8wallace8/AVMeter/README.md

"# AVMeter"

Versiion 1.2 fixes input order for LM6105.  Also adds negative voltage supply directly from PSU's board.
