8wallace8/AVMeter/Kicad/BOM.xlsx

Type | value5 | quantity | datasheet | mouser/digikey | last order | In Stock | Need
Cap | 0.1uf | 11 | https://www.mouser.com/datasheet/2/212/KEM_C1002_X7R_SMD-1102033.pdf | https://www.mouser.com/ProductDetail/80-C1206C104K5R7210 | 50 | 25 | 14
Cap | 10uf | 2 | https://www.mouser.com/datasheet/2/400/lcc_commercial_general_en-837201.pdf | https://www.mouser.com/ProductDetail/810-C3216JB1C106K16A | 20 | 17 | 15
Cap | 220nf | 3 | https://www.mouser.com/datasheet/2/427/vjw1bcbascomseries-223529.pdf | https://www.mouser.com/ProductDetail/77-VJ1206Y224MXATBC | 20 | 14 | 11
Cap | 820uf | 4 | https://www.mouser.com/datasheet/2/315/ABA0000C1255-1128316.pdf | https://www.mouser.com/ProductDetail/667-EEU-FS1A821 | 0 |  | -4
D1 | LM4040DBZ-2.0 | 1 | http://www.ti.com/general/docs/suppproductinfo.tsp?distId=26 | https://www.mouser.com/ProductDetail/926-LM4040AIM3X20NPB | 3 | 2 | 1
D2 | 1N4448WQ | 1 | https://www.mouser.com/datasheet/2/115/ds12002-536532.pdf | https://www.mouser.com/ProductDetail/621-1N4448WQ-7-F | 10 | 7 | 6
Resistor | 1.5K | 3 | https://www.mouser.com/datasheet/2/54/hpreztr-777398.pdf | https://www.mouser.com/ProductDetail/652-CR1206FX-1501ELF | 100 | 50 | 47
Resistor | 10K | 1 | https://www.mouser.com/datasheet/2/427/crcwce3-1223726.pdf | https://www.mouser.com/ProductDetail/71-CRCW120610K0FKEAC | 20 | 26 | 25
Resistor | 150 | 6 | https://www.mouser.com/datasheet/2/315/AOA0000C307-1149632.pdf | https://www.mouser.com/ProductDetail/667-ERA-8AEB151V | 10 | 8 | 2
Resistor | 18K | 4 | https://www.mouser.com/datasheet/2/315/AOA0000C307-1149632.pdf | https://www.mouser.com/ProductDetail/667-ERA-8AEB183V | 10 | 8 | 4
Resistor | 1K | 3 | https://www.mouser.com/datasheet/2/315/AOA0000C307-1149632.pdf | https://www.mouser.com/ProductDetail/667-ERA-8AEB102V | 6 | 9 | 6
Resistor | 330 | 3 | https://www.mouser.com/datasheet/2/447/PYu-AC_51_RoHS_L_6-1152827.pdf | https://www.mouser.com/ProductDetail/603-AC1206JR-07330RL | 30 | 24 | 21
Resistor | 3K | 1 | https://www.mouser.com/datasheet/2/315/AOA0000C304-1149620.pdf | https://www.mouser.com/ProductDetail/667-ERJ-8ENF3001V | 20 | 19 | 18
Resistor | 50m | 3 | https://www.mouser.com/datasheet/2/315/AOA0000C325-1316773.pdf | https://www.mouser.com/ProductDetail/667-ERJ-B2CFR05V | 3 | 3 | 0
U1 | LT6105 | 3 | https://www.mouser.com/datasheet/2/609/6105fa-1269918.pdf | https://www.mouser.com/ProductDetail/584-LT6105IMS8%23PBF | 3 |  | -3
U4 | LM321 | 1 | http://www.ti.com/general/docs/suppproductinfo.tsp?distId=26 | https://www.mouser.com/ProductDetail/926-LM321MFX-NOPB | 3 | 1 | 0
U5 | MCP3208 | 1 | https://www.mouser.com/datasheet/2/268/21298e-1101808.pdf | https://www.mouser.com/ProductDetail/579-MCP3208T-CI-SL | 3 | 1 | 0
U6 | ATmega328-PU | 1 | https://www.mouser.com/datasheet/2/268/Atmel-8271-8-bit-AVR-Microcontroller-ATmega48A-48P-1315288.pdf | https://www.mouser.com/ProductDetail/556-ATMEGA328-PU | 3 | 2 | 1
U7 | L7805 | 1 | https://www.mouser.com/datasheet/2/389/l78-974043.pdf | https://www.mouser.com/ProductDetail/511-L7805CDT-TR | 3 | 1 | 0
