8wallace8/AVMeter/Kicad/AVMeter.kicad_pcb

## KiCad design Kicad/AVMeter.kicad_pcb (2019-08-14)

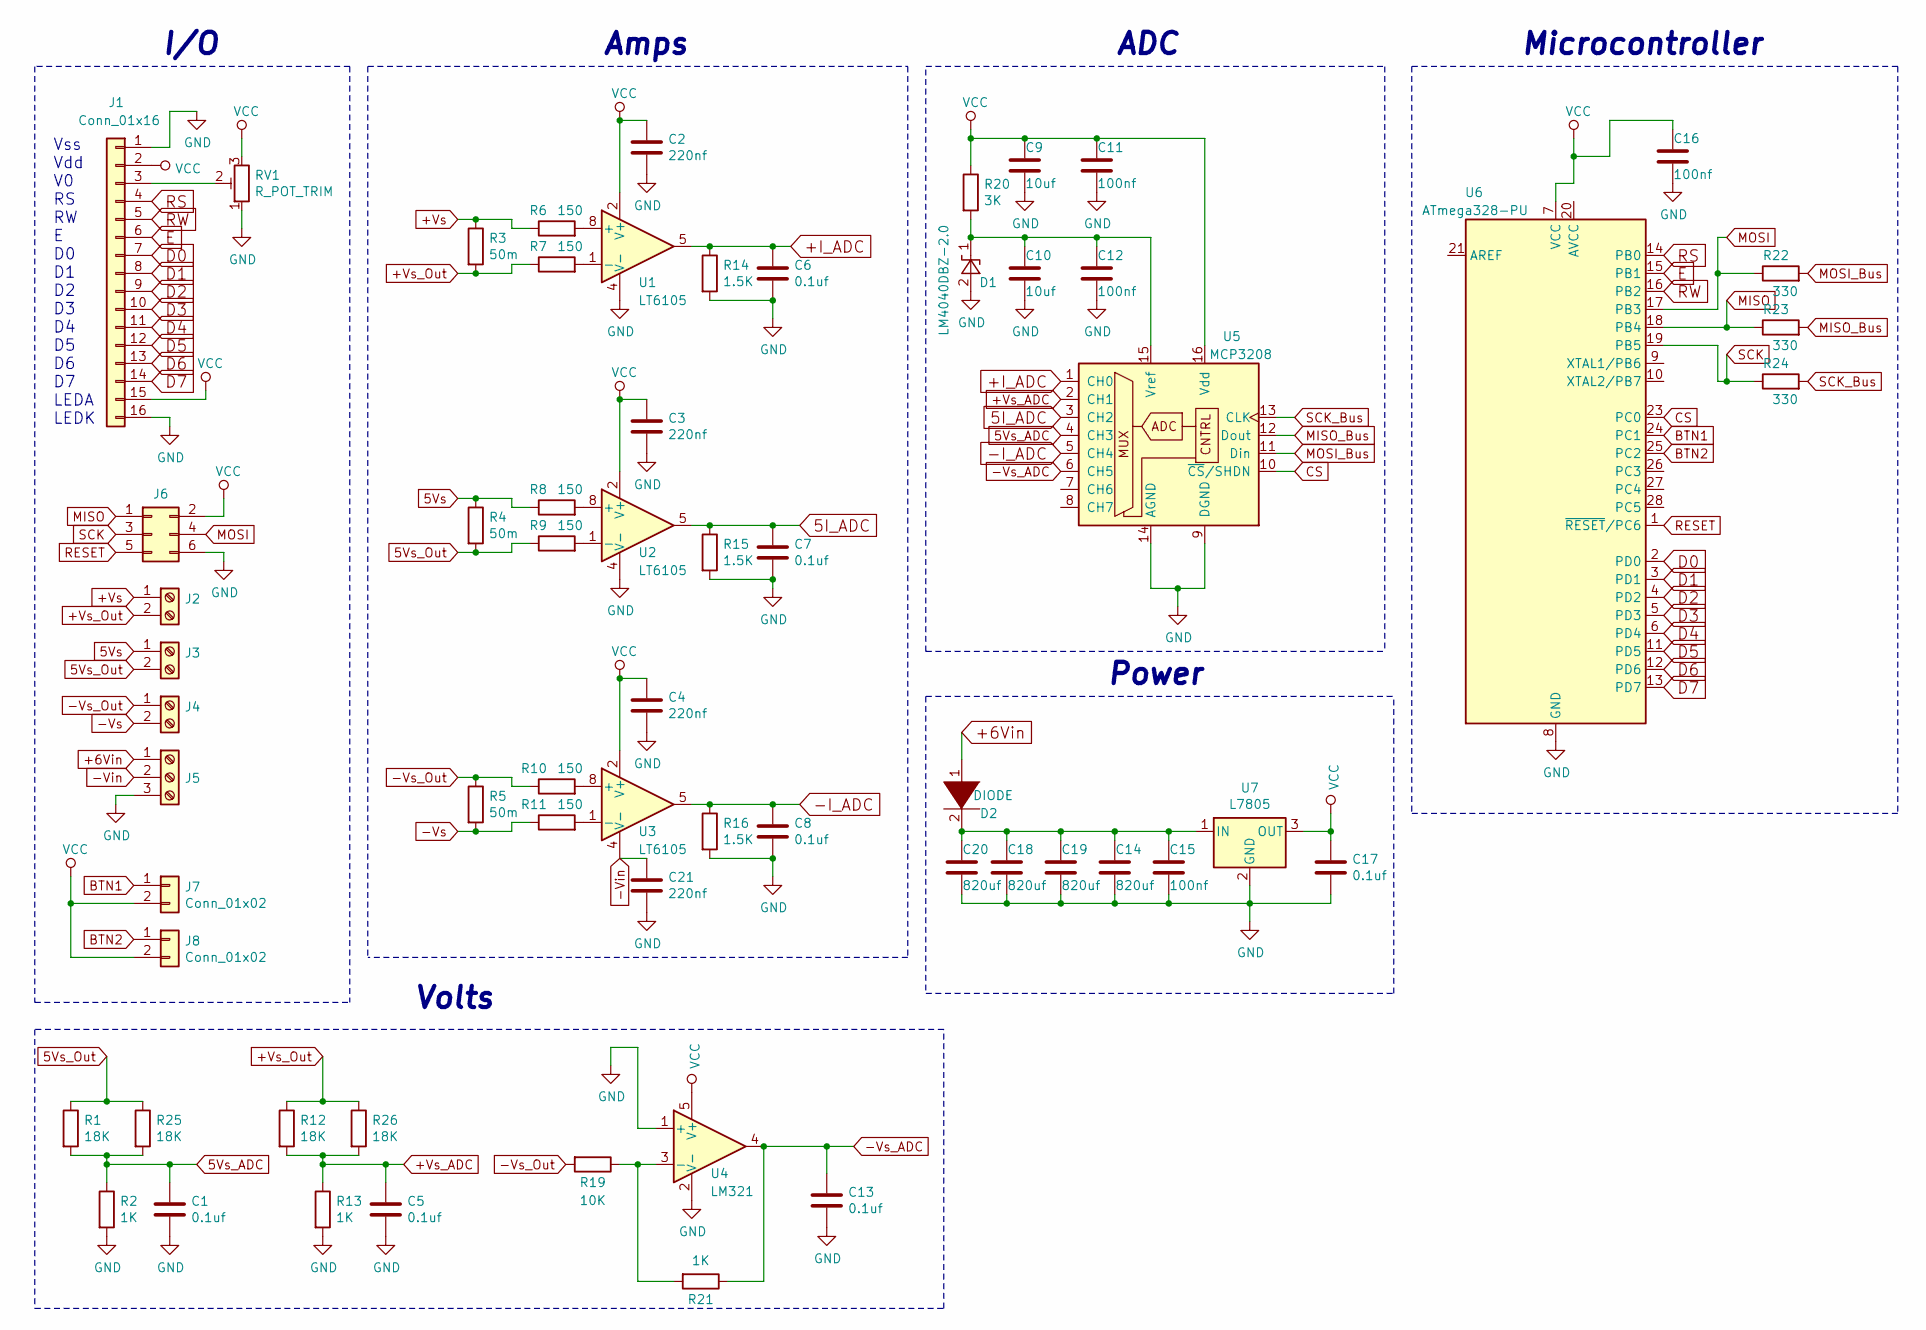
[picture p1: schematic AVMeter.sch]

Parts:
C1, C5, C6, C7, C8, C13, C17: 0.1uf; C_1206_3216Metric_Pad1.42x1.75mm_HandSolder
C2, C3, C4, C21: 220nf; C_1206_3216Metric_Pad1.42x1.75mm_HandSolder
C9, C10: 10uf; C_1206_3216Metric_Pad1.42x1.75mm_HandSolder
C11, C12, C15, C16: 100nf; C_1206_3216Metric_Pad1.42x1.75mm_HandSolder
C14, C18, C19, C20: 820uf; CP_Radial_D8.0mm_P3.50mm
D1: LM4040DBZ-2.0; SOT-23
D2: DIODE; D_SOD-123F
J1: Conn_01x16; PinHeader_1x16_P2.54mm_Vertical
J2, J3, J4: Screw_Terminal_01x02; KF301_2Pin_5Pitch
J5: Screw_Terminal_01x03; KF301_3Pin_5Pitch
J6: Conn_02x03_Odd_Even; PinHeader_2x03_P2.54mm_Vertical
J7, J8: Conn_01x02; PinSocket_1x02_P2.54mm_Vertical
R1, R12, R25, R26: 18K; R_1206_3216Metric_Pad1.42x1.75mm_HandSolder
R2, R13, R21: 1K; R_1206_3216Metric_Pad1.42x1.75mm_HandSolder
R3, R4, R5: 50m; R_0612_1632Metric_Pad1.18x3.40mm_HandSolder
R6, R7, R8, R9, R10, R11: 150; R_1206_3216Metric_Pad1.42x1.75mm_HandSolder
R14, R15, R16: 1.5K; R_1206_3216Metric_Pad1.42x1.75mm_HandSolder
R19: 10K; R_1206_3216Metric_Pad1.42x1.75mm_HandSolder
R20: 3K; R_1206_3216Metric_Pad1.42x1.75mm_HandSolder
R22, R23, R24: 330; R_1206_3216Metric_Pad1.42x1.75mm_HandSolder
RV1: R_POT_TRIM; PinHeader_1x03_P2.54mm_Vertical
U1, U2, U3: LT6105; MSOP-8_3x3mm_P0.65mm
U4: LM321; SOT-23-5
U5: MCP3208; SOIC-16_3.9x9.9mm_P1.27mm
U6: ATmega328-PU; DIP-28_W7.62mm
U7: L7805; L7805CDT-TR-DPAK

Connections:
5I_ADC: C7.1, R15.1, U2.5, U5.3 (CH2)
5Vs: J3.1, R4.1, R8.1
5Vs_ADC: C1.1, R1.2, R2.1, R25.2, U5.4 (CH3)
5Vs_Out: J3.2, R1.1, R4.2, R9.1, R25.1
+6Vin: D2.1 (K), J5.1
+I_ADC: C6.1, R14.1, U1.5, U5.1 (CH0)
+Vs: J2.1, R3.1, R6.1
+Vs_ADC: C5.1, R12.2, R13.1, R26.2, U5.2 (CH1)
+Vs_Out: J2.2, R3.2, R7.1, R12.1, R26.1
-I_ADC: C8.1, R16.1, U3.5, U5.5 (CH4)
-Vin: C21.1, J5.2, U3.4 (V-)
-Vs: J4.2, R5.2, R11.1
-Vs_ADC: C13.1, R21.1, U4.4, U5.6 (CH5)
-Vs_Out: J4.1, R5.1, R10.1, R19.2
BTN1: J7.1, U6.24 (PC1)
BTN2: J8.1, U6.25 (PC2)
CS: U5.10 (~CS~/SHDN), U6.23 (PC0)
D0: J1.7, U6.2 (PD0)
D1: J1.8, U6.3 (PD1)
D2: J1.9, U6.4 (PD2)
D3: J1.10, U6.5 (PD3)
D4: J1.11, U6.6 (PD4)
D5: J1.12, U6.11 (PD5)
D6: J1.13, U6.12 (PD6)
D7: J1.14, U6.13 (PD7)
E: J1.6, U6.15 (PB1)
GND: C1.2, C2.2, C3.2, C4.2, C5.2, C6.2, C7.2, C8.2, C9.2, C10.2, C11.2, C12.2, C13.2, C14.2, C15.2, C16.2, C17.2, C18.2, C19.2, C20.2, C21.2, D1.2 (A), J1.1, J1.16, J5.3, J6.6, R2.2, R13.2, R14.2, R15.2, R16.2, RV1.1, U1.4 (V-), U2.4 (V-), U4.1 (+), U4.2 (V-), U5.9 (DGND), U5.14 (AGND), U6.8 (GND), U6.22 (GND), U7.2 (GND)
MISO: J6.1, R23.1, U6.18 (PB4)
MISO_Bus: R23.2, U5.12 (Dout)
MOSI: J6.4, R22.1, U6.17 (PB3)
MOSI_Bus: R22.2, U5.11 (Din)
unnamed: C10.1, C12.1, D1.1 (K), R20.2, U5.15 (Vref)
unnamed: C14.1, C15.1, C18.1, C19.1, C20.1, D2.2 (A), U7.1 (IN)
unnamed: J1.3, RV1.2
unnamed: R6.2, U1.8 (+)
unnamed: R7.2, U1.1 (-)
unnamed: R8.2, U2.8 (+)
unnamed: R9.2, U2.1 (-)
unnamed: R10.2, U3.8 (+)
unnamed: R11.2, U3.1 (-)
unnamed: R19.1, R21.2, U4.3 (-)
RESET: J6.5, U6.1 (~RESET~/PC6)
RS: J1.4, U6.14 (PB0)
RW: J1.5, U6.16 (PB2)
SCK: J6.3, R24.1, U6.19 (PB5)
SCK_Bus: R24.2, U5.13 (CLK)
VCC: C2.1, C3.1, C4.1, C9.1, C11.1, C16.1, C17.1, J1.2, J1.15, J6.2, J7.2, J8.2, R20.1, RV1.3, U1.2 (V+), U2.2 (V+), U3.2 (V+), U4.5 (V+), U5.16 (Vdd), U6.7 (VCC), U7.3 (OUT)

Notes on the sheet:
Vss Vdd V0 RS RW E D0 D1 D2 D3 D4 D5 D6 D7 LEDA LEDK
I/O
Amps
ADC
Microcontroller
Power
Volts

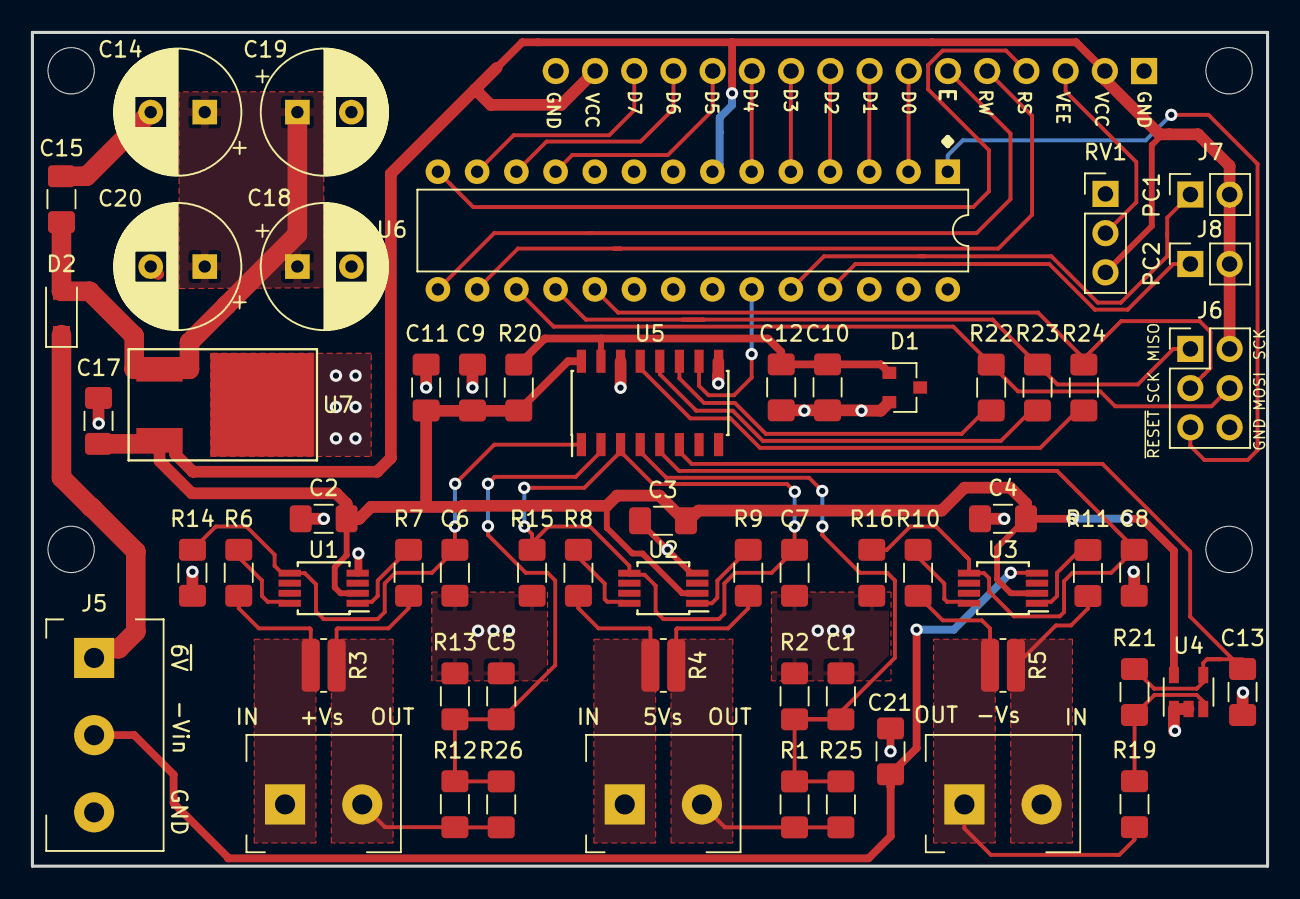
[picture p2: board AVMeter.kicad_pcb from above]

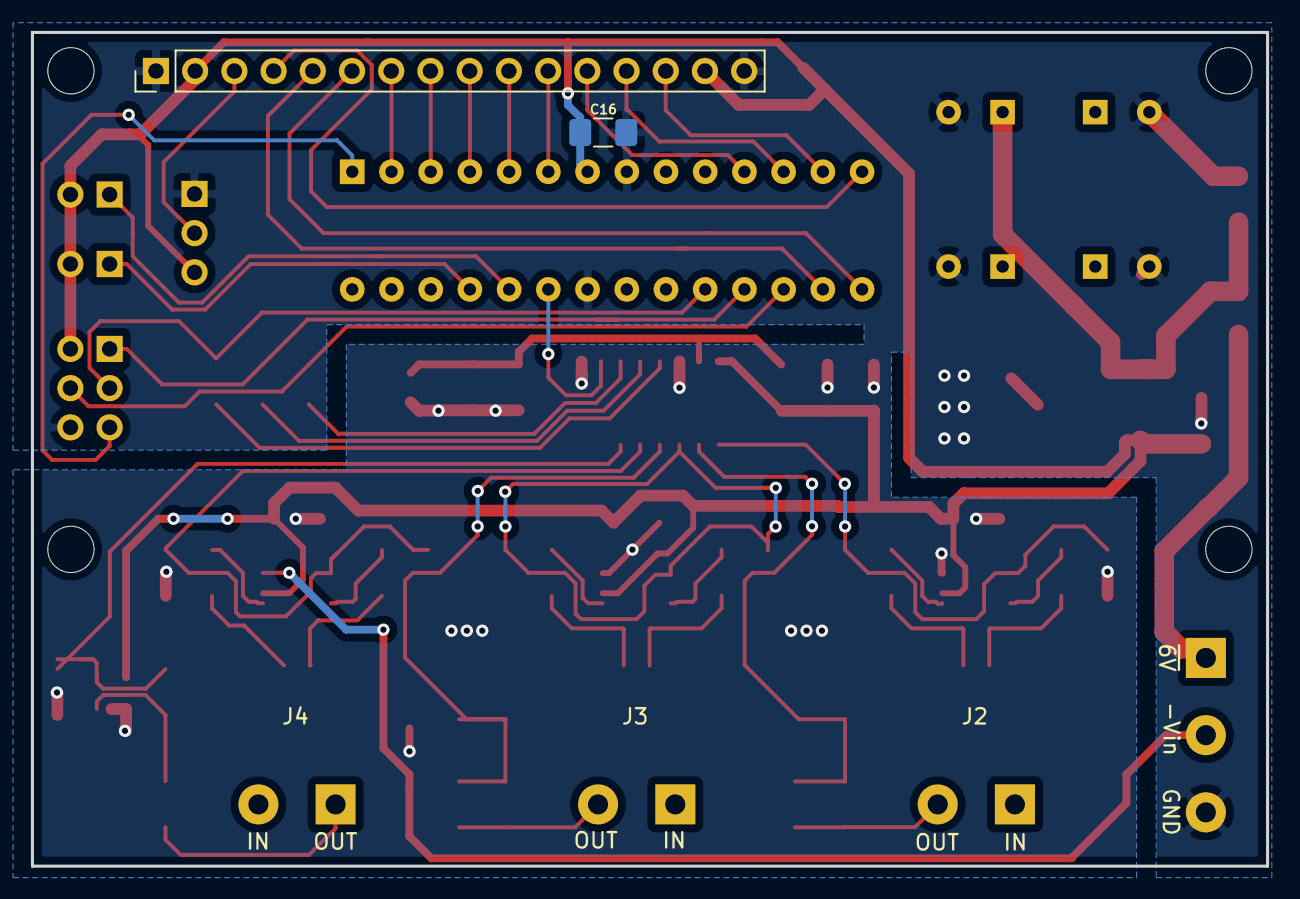
[picture p3: board AVMeter.kicad_pcb from below]

Board: 2 copper layers, 80.0 x 54.0 mm, 63 parts (2 on the bottom side), 47 nets.
