8wallace8/AVMeter/Code/AVMeter/lcd_4bit.h

/*
 * lcd.h
 *
 * Created: 2/3/2019 3:05:04 PM
 *  Author: dkyle
 */ 

#ifndef ldc
#define ldc

#include <avr/io.h>			/* Include AVR std. library file */
#include <util/delay.h>			/* Include Delay header file */

#define LCD_Dir  DDRD			/* Define LCD data port direction */
#define LCD_Port PORTD			/* Define LCD data port */
#define CONTROL_Dir DDRB
#define CONTROL_Port PORTB
#define RS PINB0				/* Define Register Select pin */
#define EN PINB1 				/* Define Enable signal pin */
#define RW PINB2

void LCD_Command( unsigned char cmnd );
void LCD_Char( unsigned char data );
void LCD_Init (void);			/* LCD Initialize function */
void LCD_String (char *str);		/* Send string to LCD function */
void LCD_String_xy (char row, char pos, char *str);	/* Send string to LCD with xy position */
void LCD_Clear(void);
void LCD_Custom_Char (unsigned char loc, unsigned char *msg);



void LCD_Command( unsigned char cmnd )
{
	LCD_Port = (LCD_Port & 0x0F) | (cmnd & 0xF0); /* sending upper nibble */
	CONTROL_Port &= ~ (1<<RS);		/* RS=0, command reg. */
	CONTROL_Port |= (1<<EN);		/* Enable pulse */
	_delay_us(1);
	CONTROL_Port &= ~ (1<<EN);

	_delay_us(200);

	LCD_Port = (LCD_Port & 0x0F) | (cmnd << 4);  /* sending lower nibble */
	CONTROL_Port |= (1<<EN);
	_delay_us(1);
	CONTROL_Port &= ~ (1<<EN);
	_delay_ms(2);
}


void LCD_Char( unsigned char data )
{
	LCD_Port = (LCD_Port & 0x0F) | (data & 0xF0); /* sending upper nibble */
	CONTROL_Port |= (1<<RS);		/* RS=1, data reg. */
	CONTROL_Port|= (1<<EN);
	_delay_us(1);
	CONTROL_Port &= ~ (1<<EN);

	_delay_us(200);

	LCD_Port = (LCD_Port & 0x0F) | (data << 4); /* sending lower nibble */
	CONTROL_Port |= (1<<EN);
	_delay_us(1);
	CONTROL_Port &= ~ (1<<EN);
	_delay_ms(2);
}

void LCD_Init (void)			/* LCD Initialize function */
{
	LCD_Dir = 0xFF;			/* Make LCD port direction as o/p */
	CONTROL_Dir = 0xFF;
	
	_delay_ms(20);			/* LCD Power ON delay always >15ms */
	
	LCD_Command(0x02);		/* send for 4 bit initialization of LCD  */
	LCD_Command(0x28);              /* 2 line, 5*7 matrix in 4-bit mode */
	LCD_Command(0x0c);              /* Display on cursor off*/
	LCD_Command(0x06);              /* Increment cursor (shift cursor to right)*/
	LCD_Command(0x01);              /* Clear display screen*/
	_delay_ms(2);
}


void LCD_String (char *str)		/* Send string to LCD function */
{
	int i;
	for(i=0;str[i]!=0;i++)		/* Send each char of string till the NULL */
	{
		LCD_Char (str[i]);
	}
}

void LCD_String_xy (char row, char pos, char *str)	/* Send string to LCD with xy position */
{
	if (row == 0 && pos<16)
	LCD_Command((pos & 0x0F)|0x80);	/* Command of first row and required position<16 */
	else if (row == 1 && pos<16)
	LCD_Command((pos & 0x0F)|0xC0);	/* Command of first row and required position<16 */
	LCD_String(str);		/* Call LCD string function */
}

void LCD_Clear()
{
	LCD_Command (0x01);		/* Clear display */
	_delay_ms(2);
	LCD_Command (0x80);		/* Cursor at home position */
}

#endif
/*
Commands

1	01	Clear display screen
2	02	Return home
3	04	Decrement cursor (shift cursor to left)
4	06	Increment cursor (shift cursor to right)
5	05	Shift display right
6	07	Shift display left
7	08	Display off, cursor off
8	0A	Display off, cursor on
9	0C	Display on, cursor off
10	0E	Display on, cursor blinking
11	0F	Display on, cursor blinking
12	10	Shift cursor position to left
13	14	Shift cursor position to right
14	18	Shift the entire display to the left
15	1C	Shift the entire display to the right
16	80	Force cursor to beginning ( 1st line)
17	C0	Force cursor to beginning ( 2nd line)
18	38	2 lines and 5×7 matrix
*/
