8wallace8/AVMeter/(commit log)

2019-04-28 second commit
    [AVMeter.csv, AVMeter.kicad_pcb, AVMeter.sch, BOM.xlsx]
2019-08-11 fix for LM6105
    [AVMeter.kicad_pcb, AVMeter.sch]
2019-08-12 added mount holes and other
    [AVMeter.kicad_pcb, AVMeter.sch, BOM.xlsx]
2019-08-12 updated sheet info
    [AVMeter.sch]
2019-08-14 release V 1.2
    [AVMeter.kicad_pcb]
